yohummus/nordic-clicker/hardware/swd_adapter/swd_adapter.kicad_pcb

## KiCad design hardware/swd_adapter/swd_adapter.kicad_pcb (2025-02-26)

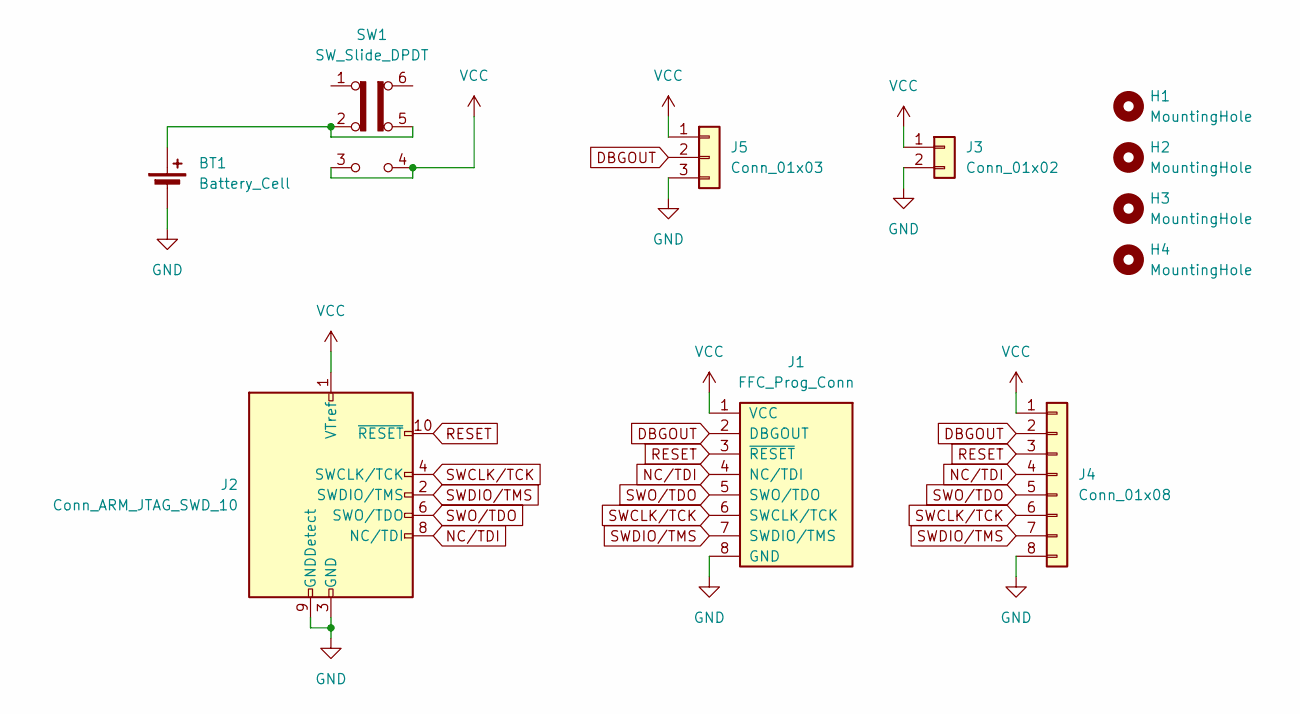
[picture p1: schematic swd_adapter.kicad_sch]

Parts:
BT1: Battery_Cell; BatteryHolder_Keystone_1060_1x2032; MPN 1060TR; Mouser-PN 534-1060TR
H1, H2, H3, H4: MountingHole; MountingHole_3.2mm_M3
J1: FFC_Prog_Conn; Molex_505110-0892; MPN 505110-0892; Mouser-PN 538-505110-0892
J2: Conn_ARM_JTAG_SWD_10; PinHeader_2x05_P1.27mm_Vertical_SMD; MPN 4048; Mouser-PN 485-4048
J3: Conn_01x02; PinHeader_1x02_P2.54mm_Vertical
J4: Conn_01x08; PinHeader_1x08_P2.54mm_Vertical
J5: Conn_01x03; PinHeader_1x03_P2.54mm_Vertical
SW1: SW_Slide_DPDT; SW_CK_JS202011CQN_DPDT_Straight; MPN JS202011CQN; Mouser-PN 611-JS202011CQN

Connections:
DBGOUT: J1.2 (DBGOUT), J4.2, J5.2
GND: BT1.2 (-), J1.8 (GND), J2.3 (GND), J2.5 (GND), J2.9 (GNDDetect), J3.2, J4.8, J5.3
NC/TDI: J1.4 (NC/TDI), J2.8 (NC/TDI), J4.4
unnamed: BT1.1 (+), SW1.2 (B), SW1.5 (B)
RESET: J1.3 (~RESET), J2.10 (~RESET), J4.3
SWCLK/TCK: J1.6 (SWCLK/TCK), J2.4 (SWCLK/TCK), J4.6
SWDIO/TMS: J1.7 (SWDIO/TMS), J2.2 (SWDIO/TMS), J4.7
SWO/TDO: J1.5 (SWO/TDO), J2.6 (SWO/TDO), J4.5
VCC: J1.1 (VCC), J2.1 (VTref), J3.1, J4.1, J5.1, SW1.3 (C), SW1.4 (A)

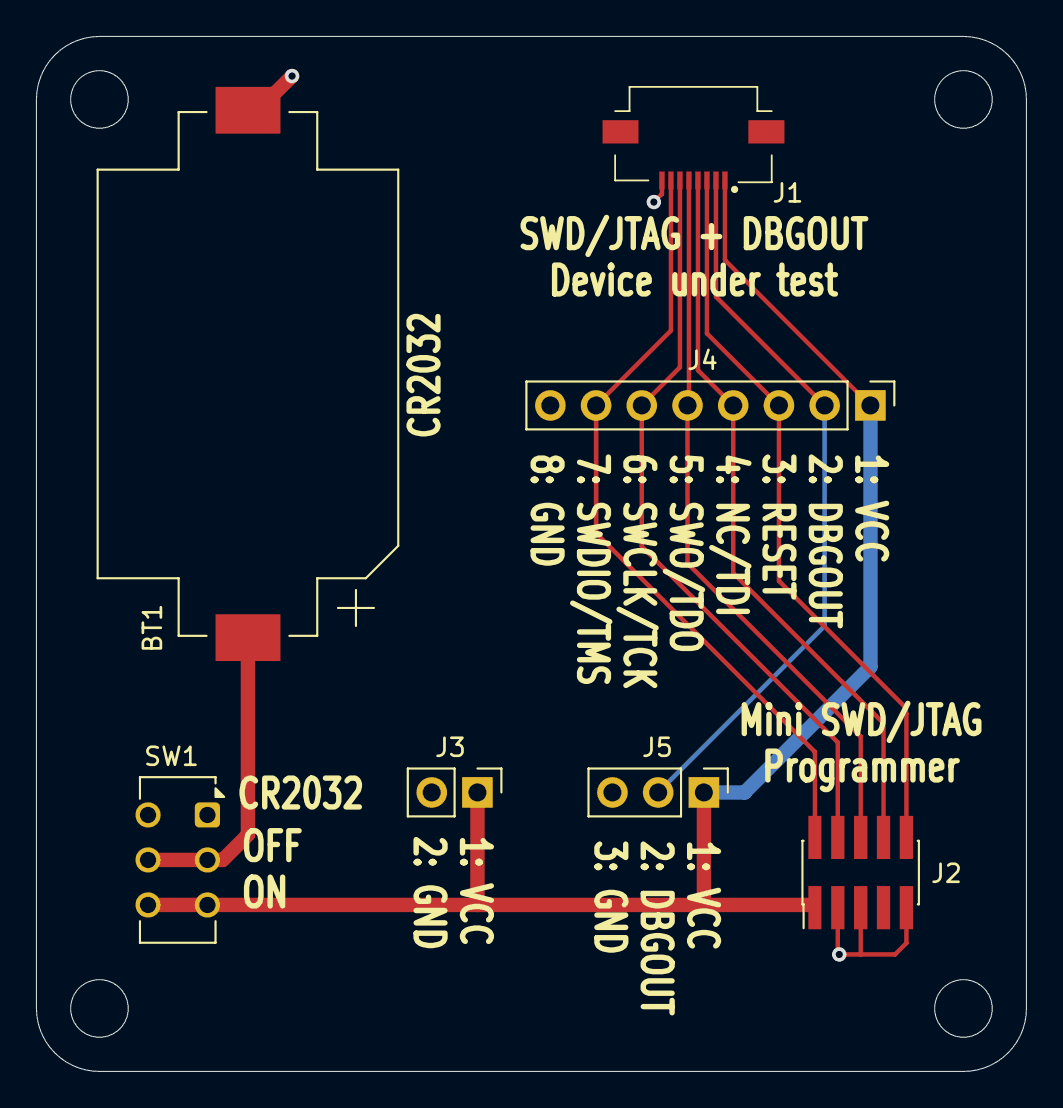
[picture p2: board swd_adapter.kicad_pcb from above]

Board: 2 copper layers, 55.0 x 57.5 mm, 11 parts (0 on the bottom side), 9 nets.
