yohummus/nordic-clicker/hardware/main_board/main_board.kicad_pcb

## KiCad design hardware/main_board/main_board.kicad_pcb (2025-02-26)

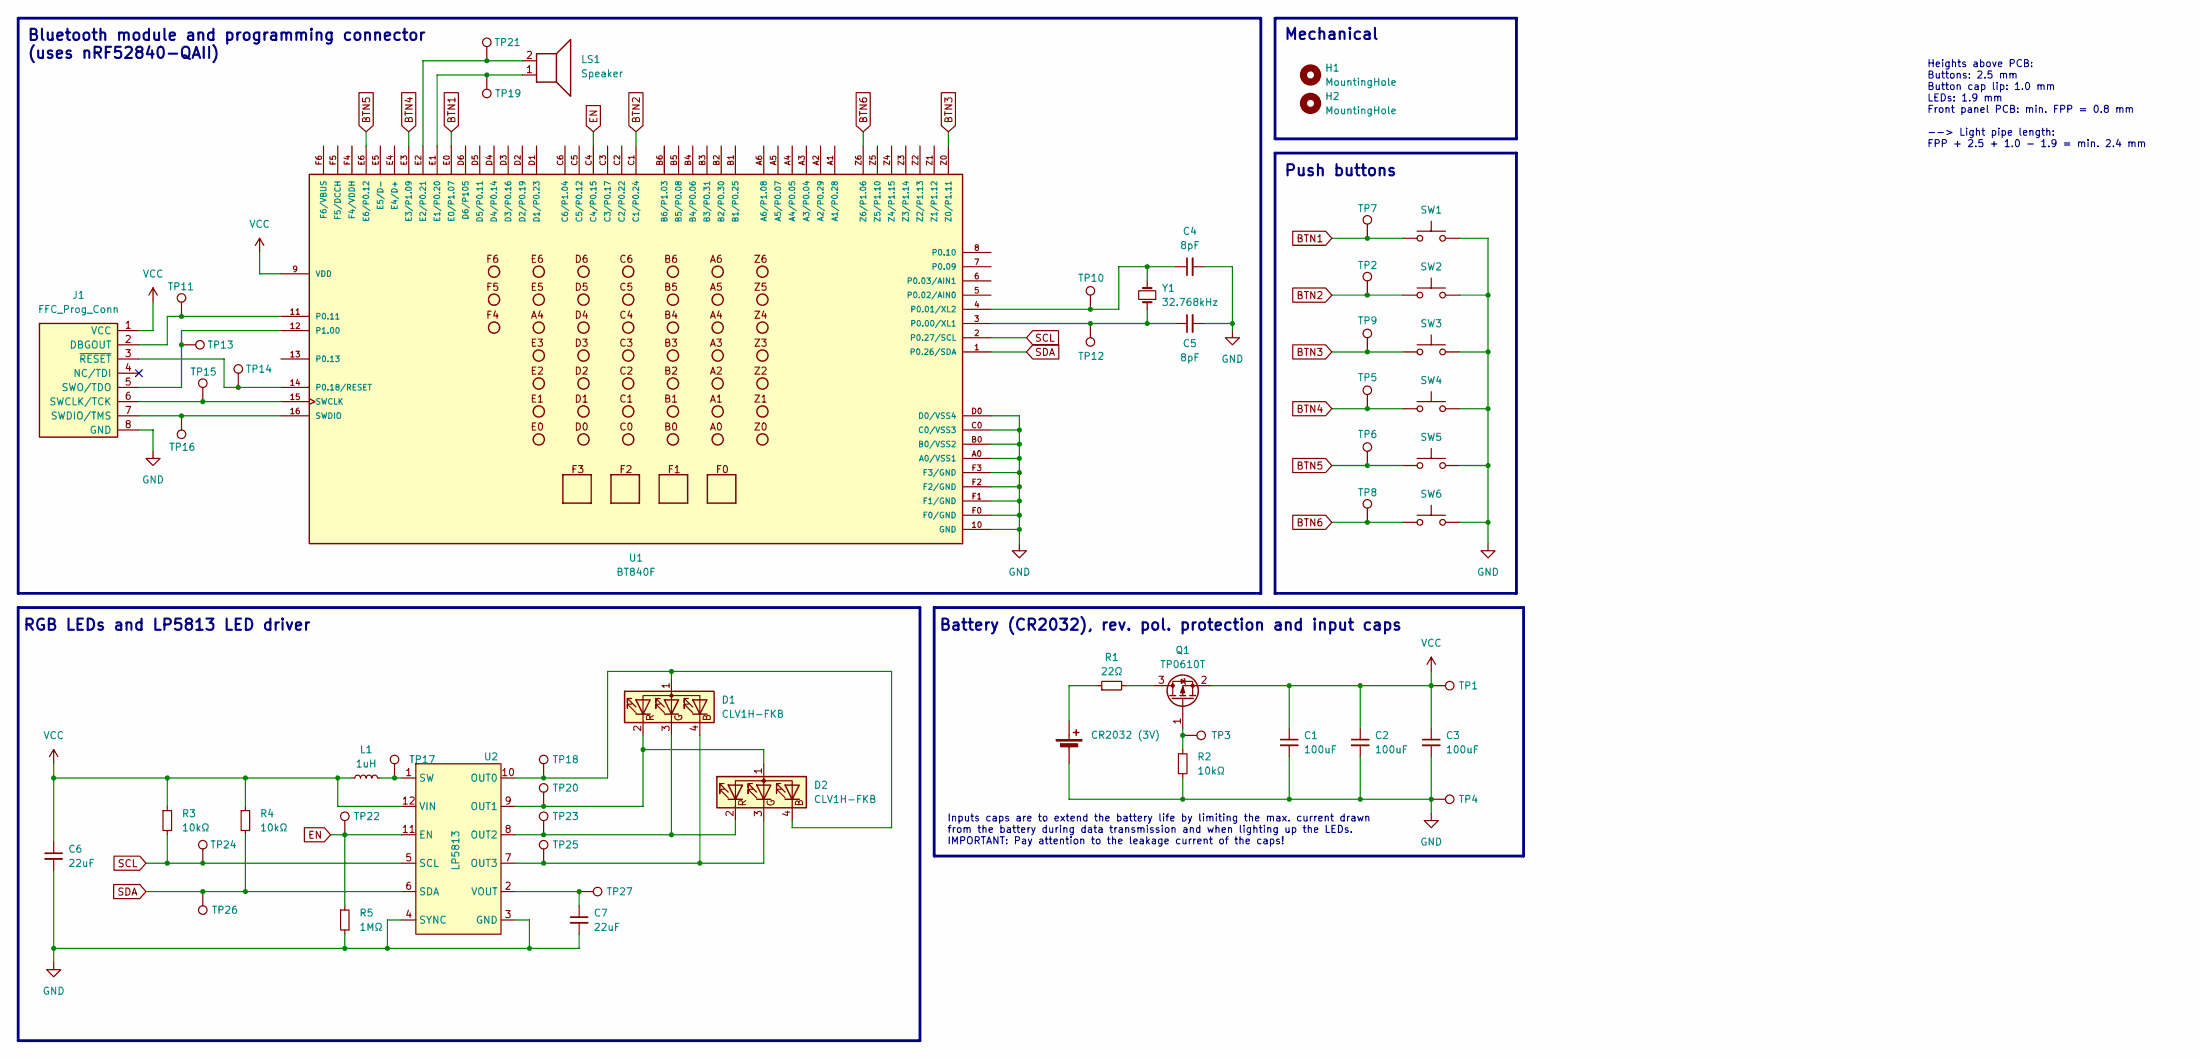
[picture p3: schematic main_board.kicad_sch, Nordic Clicker - main board]

Parts:
BT1: Keystone_2991; MPN 2991; Mouser-PN 534-2991
BT2: CR2032 (3V); BAT-HLD-001; MPN BAT-HLD-001; Mouser-PN 712-BAT-HLD-001
C1, C2, C3: 100uF; C_1206_3216Metric; Voltage 10V; Tolerance 20%; MPN C3216X5R1A107M160AC; Mouser-PN 810-C3216X5R1A107M
C4, C5: 8pF; C_0603_1608Metric; Voltage 25V; Tolerance 0.5pF; MPN 06033A8R0DAT2A; Mouser-PN 581-06033A8R0DAT2A
C6, C7: 22uF; C_0603_1608Metric; Voltage 16V; Tolerance 20%; MPN GRM188C61C226ME01J; Mouser-PN 81-GRM188C61C226ME1J
D1, D2: CLV1H-FKB; PLCC4_CLV1H-FKB; MPN CLV1H-FKB-CMPRTHKBB2367453; Mouser-PN 941-CLV1HBCTKB237453
H1, H2: MountingHole; Hole_2.5mm_Keepout_4mm
J1: FFC_Prog_Conn; Molex_505110-0892; MPN 505110-0892; Mouser-PN 538-505110-0892
L1: 1uH; SRP4020TA; MPN SRP4020TA-1R0M; Mouser-PN 652-SRP4020TA-1R0M
LS1: Speaker; Buzzer_Mallory_AST1109MLTRQ; MPN AST1109MLTRQ; Mouser-PN 539-AST1109MLTRQ
Q1: TP0610T; SOT-23; MPN SI2323DDS-T1-GE3; Mouser-PN 78-SI2323DDS-T1-GE3
R1: 22Ω; R_0603_1608Metric; Voltage 75V; Tolerance 1%; MPN CRCW060322R0FKEAC; Mouser-PN 71-CRCW060322R0FKEAC
R2, R3, R4: 10kΩ; R_0603_1608Metric; Voltage 75V; Tolerance 1%; MPN CRCW060310K0FKEAC; Mouser-PN 71-CRCW060310K0FKEAC
R5: 1MΩ; R_0603_1608Metric; Voltage 75V; Tolerance 1%; MPN CRCW06031M00FKEAC; Mouser-PN 71-CRCW06031M00FKEAC
SW1, SW2, SW3, SW4, SW5, SW6: PTS810SJG250SMTR LFS; PTS810; MPN PTS810SJG250SMTR LFS; Mouser-PN 611-PTS810SJG250SMTR
TP1, TP2, TP3, TP4, TP5, TP6, TP7, TP8, TP9, TP10, TP11, TP12, TP13, TP14, TP15, TP16, TP17, TP18, TP19, TP20, TP21, TP22, TP23, TP24, TP25, TP26, TP27: Test_Point; TestPoint_Pad_D1.0mm
U1: BT840F; MPN BT840F; Mouser-PN 308-BT840F
U2: LP5813; WSON-12; MPN LP5813CDRRR; Mouser-PN 595-LP5813CDRRR
Y1: 32.768kHz; ABS07AIG; MPN ABS07-32.768KHZ-9-T; Mouser-PN 815-ABS07-32.768K9T

Connections:
BTN1: SW1.2, TP7.1, U1.E0 (E0/P1.07)
BTN2: SW2.2, TP2.1, U1.C1 (C1/P0.24)
BTN3: SW3.2, TP9.1, U1.Z0 (Z0/P1.11)
BTN4: SW4.2, TP5.1, U1.E3 (E3/P1.09)
BTN5: SW5.2, TP6.1, U1.E6 (E6/P0.12)
BTN6: SW6.2, TP8.1, U1.Z6 (Z6/P1.06)
EN: R5.1, TP22.1, U1.C4 (C4/P0.15), U2.11 (EN)
GND: BT1.1 (-), C1.2, C2.2, C3.2, C4.2, C5.2, C6.2, C7.2, J1.8 (GND), R2.2, R5.2, SW1.1, SW2.1, SW3.1, SW4.1, SW5.1, SW6.1, TP4.1, U1.10 (GND), U1.A0 (A0/VSS1), U1.B0 (B0/VSS2), U1.C0 (C0/VSS3), U1.D0 (D0/VSS4), U1.F0 (F0/GND), U1.F1 (F1/GND), U1.F2 (F2/GND), U1.F3 (F3/GND), U2.3 (GND), U2.4 (SYNC), U2.13 (GND)
unnamed: BT2.1 (+), R1.1
unnamed: D1.1 (A), D2.4 (BK), TP18.1, U2.10 (OUT0)
unnamed: D1.4 (BK), D2.3 (GK), TP25.1, U2.7 (OUT3)
unnamed: D1.3 (GK), D2.2 (RK), TP23.1, U2.8 (OUT2)
unnamed: D1.2 (RK), D2.1 (A), TP20.1, U2.9 (OUT1)
unnamed: J1.2 (DBGOUT), TP11.1, U1.11 (P0.11)
unnamed: J1.6 (SWCLK/TCK), TP15.1, U1.15 (SWCLK)
unnamed: J1.7 (SWDIO/TMS), TP16.1, U1.16 (SWDIO)
unnamed: J1.5 (SWO/TDO), TP13.1, U1.12 (P1.00)
unnamed: J1.3 (~RESET), TP14.1, U1.14 (P0.18/RESET)
unnamed: Q1.3 (D), R1.2
unnamed: Q1.1 (G), R2.1, TP3.1
unnamed: LS1.1, TP19.1, U1.E1 (E1/P0.20)
unnamed: LS1.2, TP21.1, U1.E2 (E2/P0.21)
unnamed: C5.1, TP12.1, U1.3 (P0.00/XL1), Y1.1
unnamed: C4.1, TP10.1, U1.4 (P0.01/XL2), Y1.2
unnamed: L1.2, TP17.1, U2.1 (SW)
unnamed: C7.1, TP27.1, U2.2 (VOUT)
SCL: R3.2, TP24.1, U1.2 (P0.27/SCL), U2.5 (SCL)
SDA: R4.2, TP26.1, U1.1 (P0.26/SDA), U2.6 (SDA)
VCC: C1.1, C2.1, C3.1, C6.1, J1.1 (VCC), L1.1, Q1.2 (S), R3.1, R4.1, TP1.1, U1.9 (VDD), U2.12 (VIN)

Notes on the sheet:
Heights above PCB: Buttons: 2.5 mm Button cap lip: 1.0 mm LEDs: 1.9 mm Front panel PCB: min. FPP = 0.8 mm --> Light pipe length: FPP + 2.5 + 1.0 - 1.9 = min. 2.4 mm
Push buttons
Bluetooth module and programming connector (uses nRF52840-QAII)
Inputs caps are to extend the battery life by limiting the max. current drawn from the battery during data transmission and when lighting up the LEDs. IMPORTANT: Pay attention to the leakage current of the caps!
RGB LEDs and LP5813 LED driver
Battery (CR2032), rev. pol. protection and input caps
Mechanical

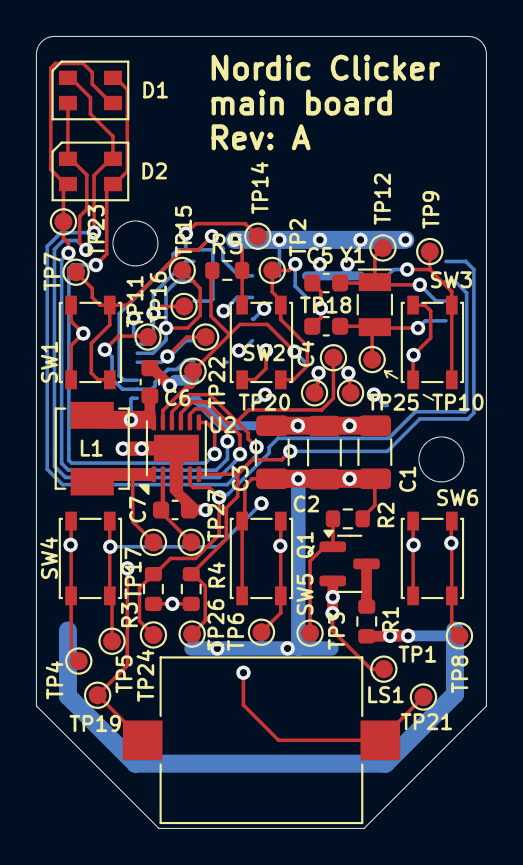
[picture p4: board main_board.kicad_pcb from above]

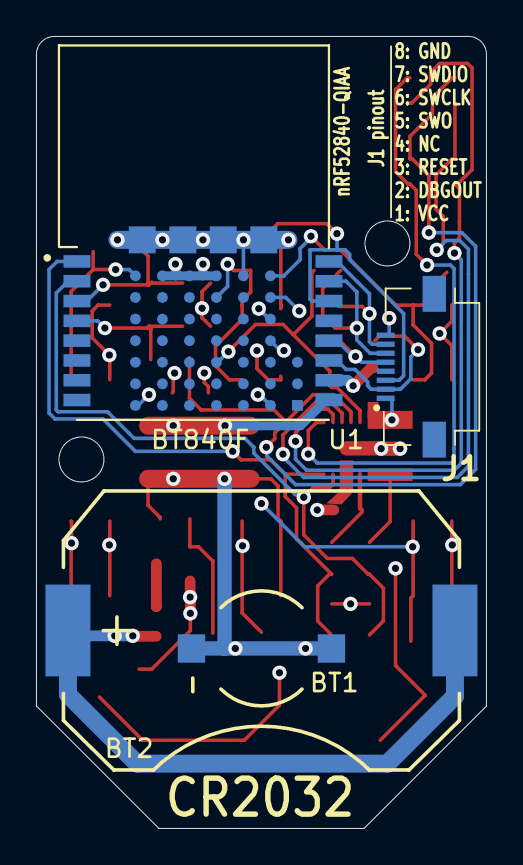
[picture p5: board main_board.kicad_pcb from below]

Board: 4 copper layers, 25.0 x 44.0 mm, 58 parts (4 on the bottom side), 29 nets.
