yohummus/nordic-clicker/(commit log)

2025-02-09 First draft of main board and front panel
    [front_panel.kicad_pcb, front_panel.kicad_sch, main_board.kicad_pcb, main_board.kicad_sch]
2025-02-15 Rev. A finished
    [front_panel.kicad_pcb, main_board.kicad_pcb, main_board.kicad_sch, swd_adapter.kicad_pcb, swd_adapter.kicad_sch]
2025-02-15 Added firmware board and app skeletons
2025-02-16 Fleshed out Zephyr board and first small hardware test
2025-02-26 Updated KiCad files to version 9.0
    [front_panel.kicad_pcb, front_panel.kicad_sch, main_board.kicad_pcb, main_board.kicad_sch, swd_adapter.kicad_pcb, swd_adapter.kicad_sch]
2025-03-05 Got LEDs and DBGOUT working, however, logging to UART does not work
    [main.c]
2025-03-22 Changed LEDs module to use FIFO and got UART for logging working
    [main_board.kicad_sch, swd_adapter.kicad_sch]
2025-03-24 Now playing Super Mario on the buzzer
    [leds.c, leds.h, main.c, speaker.c, speaker.h]
2025-03-27 Got LED driver animations working
2025-03-29 Got button interrupts working
2025-03-31 Refactored buttons module to use thread
2025-04-01 Got button press detection after wakeup from sys off working
2025-04-01 Got first battery voltage measurement working
2025-04-03 Battery module implemented
